davidcutting42/robotarm-17/MK2-WM-Roboarm/Regionals/Remaining Tasks.docx

2017 Regionals Roboarm MK2 Changes

## High Priority

### Hardware

### Software

### Operational

- Update waypoints with lifting between each waypoint (make sure end effector will not spill pennies)
- Mitigate risk of motors getting stuck/loss of penny stack
- 10 practice runs

## Low Priority

### Hardware

- Print penny harp with wider angle to make pennies more secure

### Software

- Calculate step differences every time encoders are read.
- Remove decrement code for the step differences because the encoders already manage that.
- In state machines, update code in going into state one and leaving state two so there is a dead band.
- Update modbus registers with three new variables for angle positions (degrees*100)

### Operational
