davidcutting42/robotarm-17/Robot Arm 2017 Arduino Mega Shield V2 Schematic.pdf

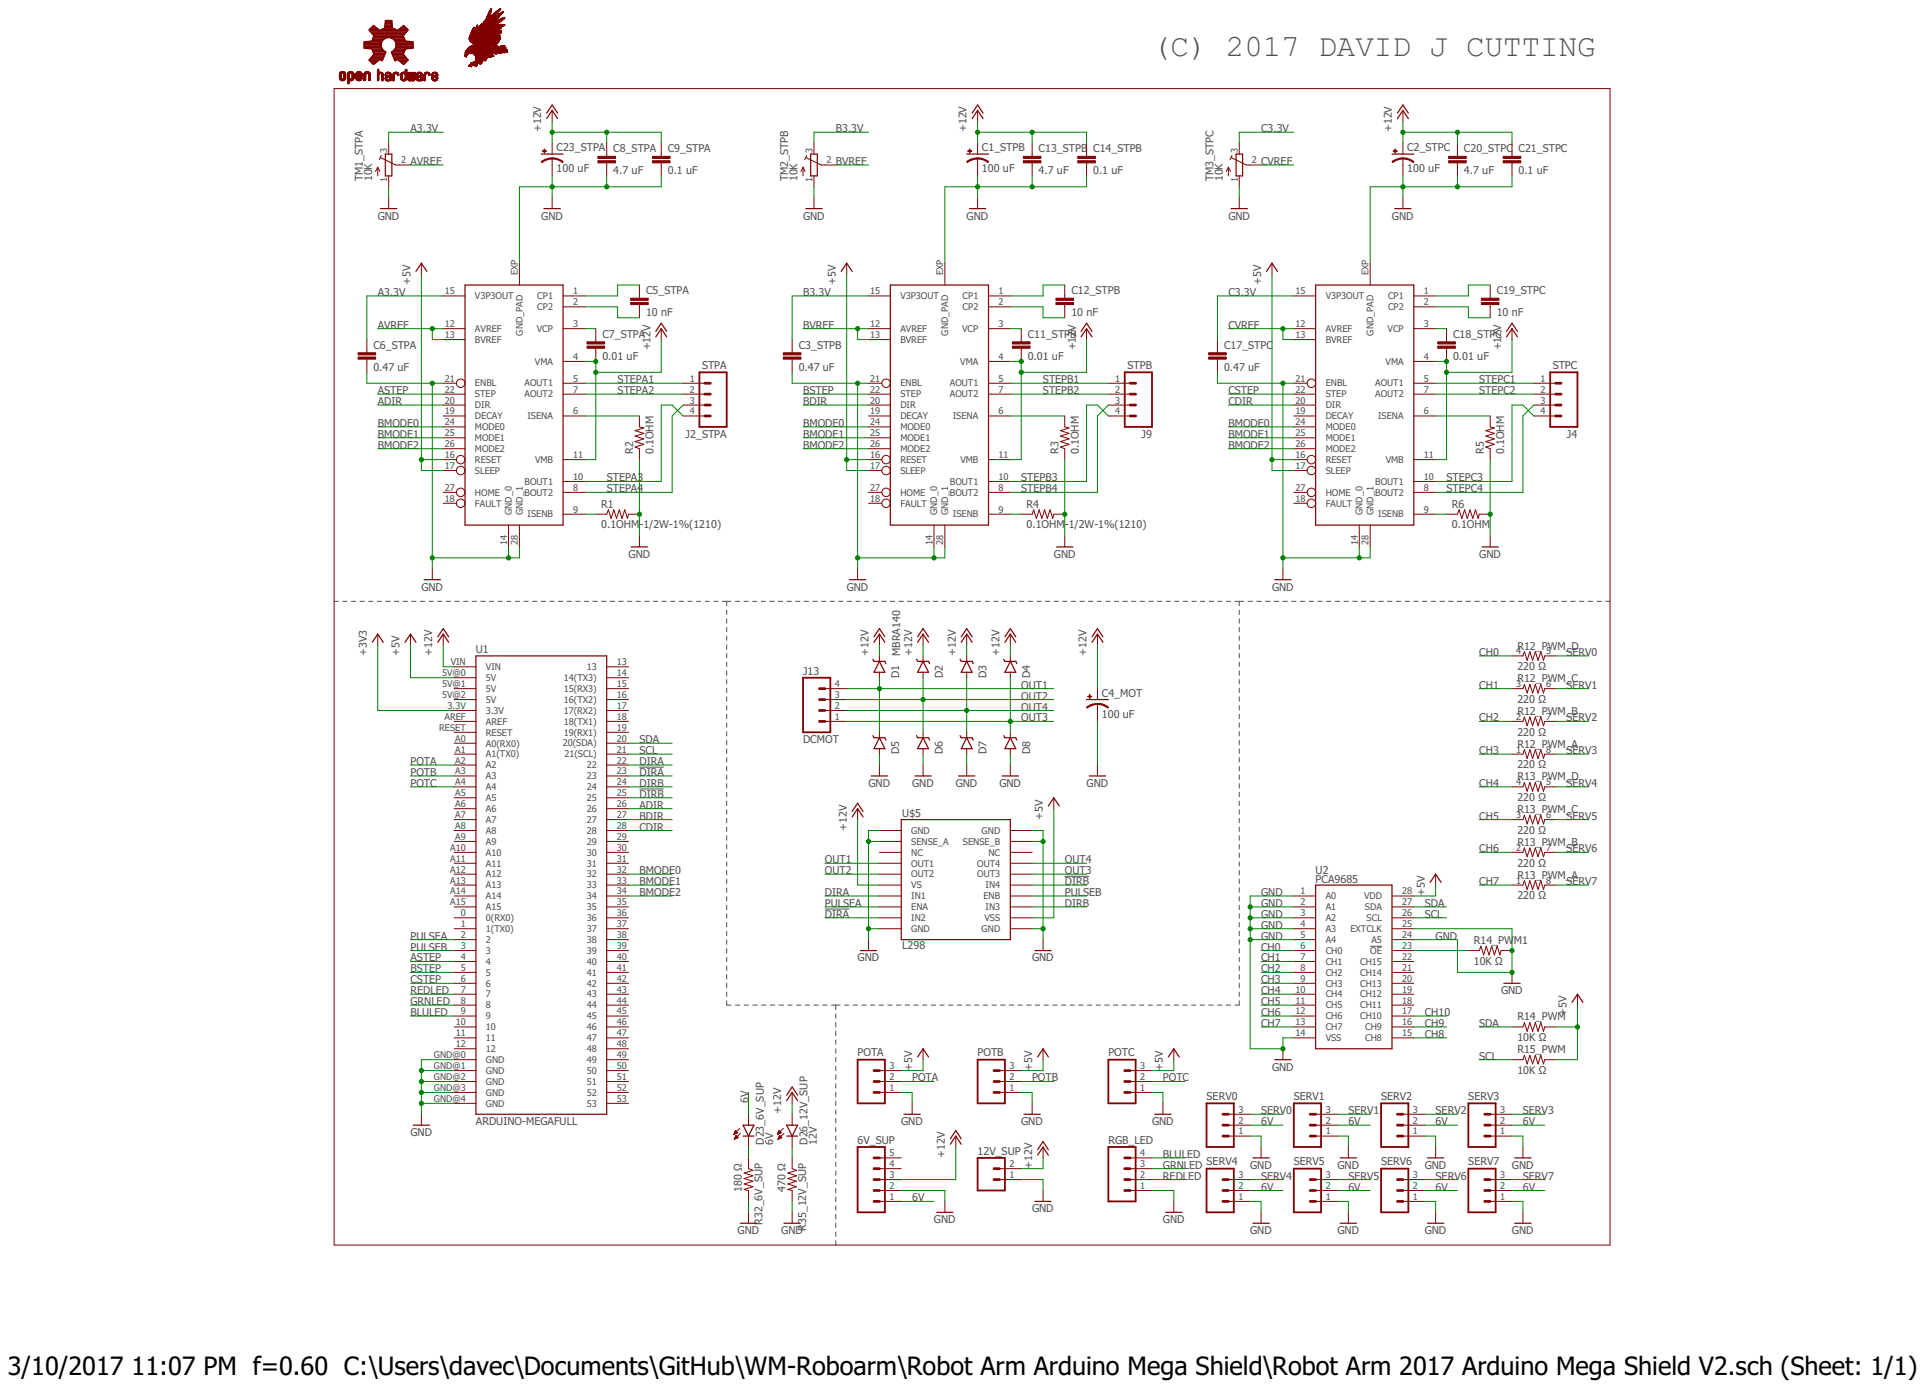
[picture p1: page 1]

MBRA140 GND GND GND GND

3/10/2017 11:07 PM f=0.60 C:\Users\davec\Documents\GitHub\WM-Roboarm\Robot Arm Arduino Mega Shield\Robot Arm 2017 Arduino Mega Shield V2.sch (Sheet: 1/1)
