davidcutting42/robotarm-17/Robot Arm 2017 Arduino Mega Shield V2.pdf

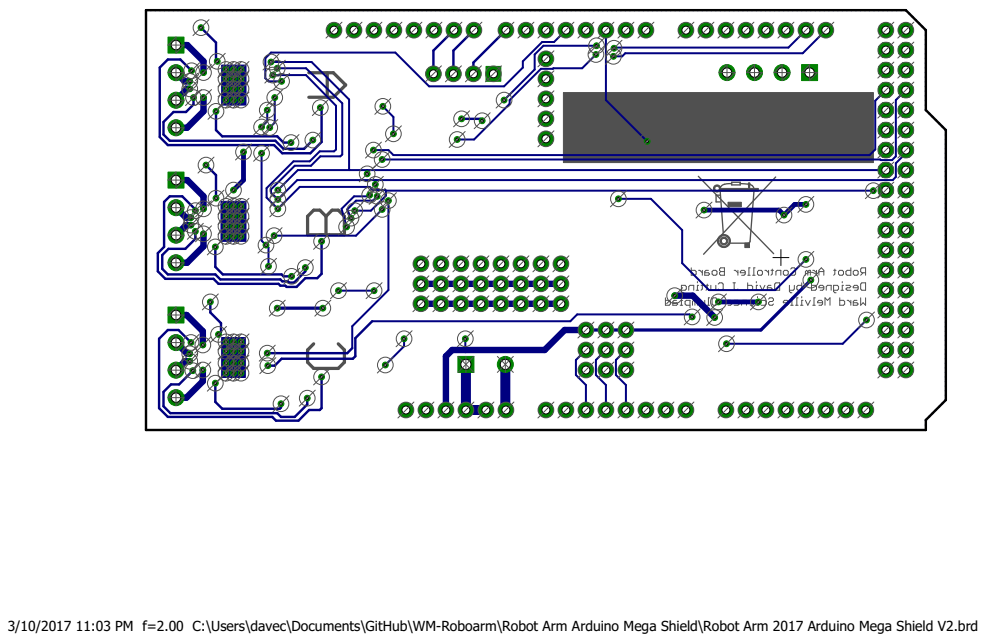
[picture p2: page 1]

3/10/2017 11:03 PM f=2.00 C:\Users\davec\Documents\GitHub\WM-Roboarm\Robot Arm Arduino Mega Shield\Robot Arm 2017 Arduino Mega Shield V2.brd
