davidcutting42/robotarm-17/MK1-WM-Roboarm/Documentation/osttexx0164.pdf

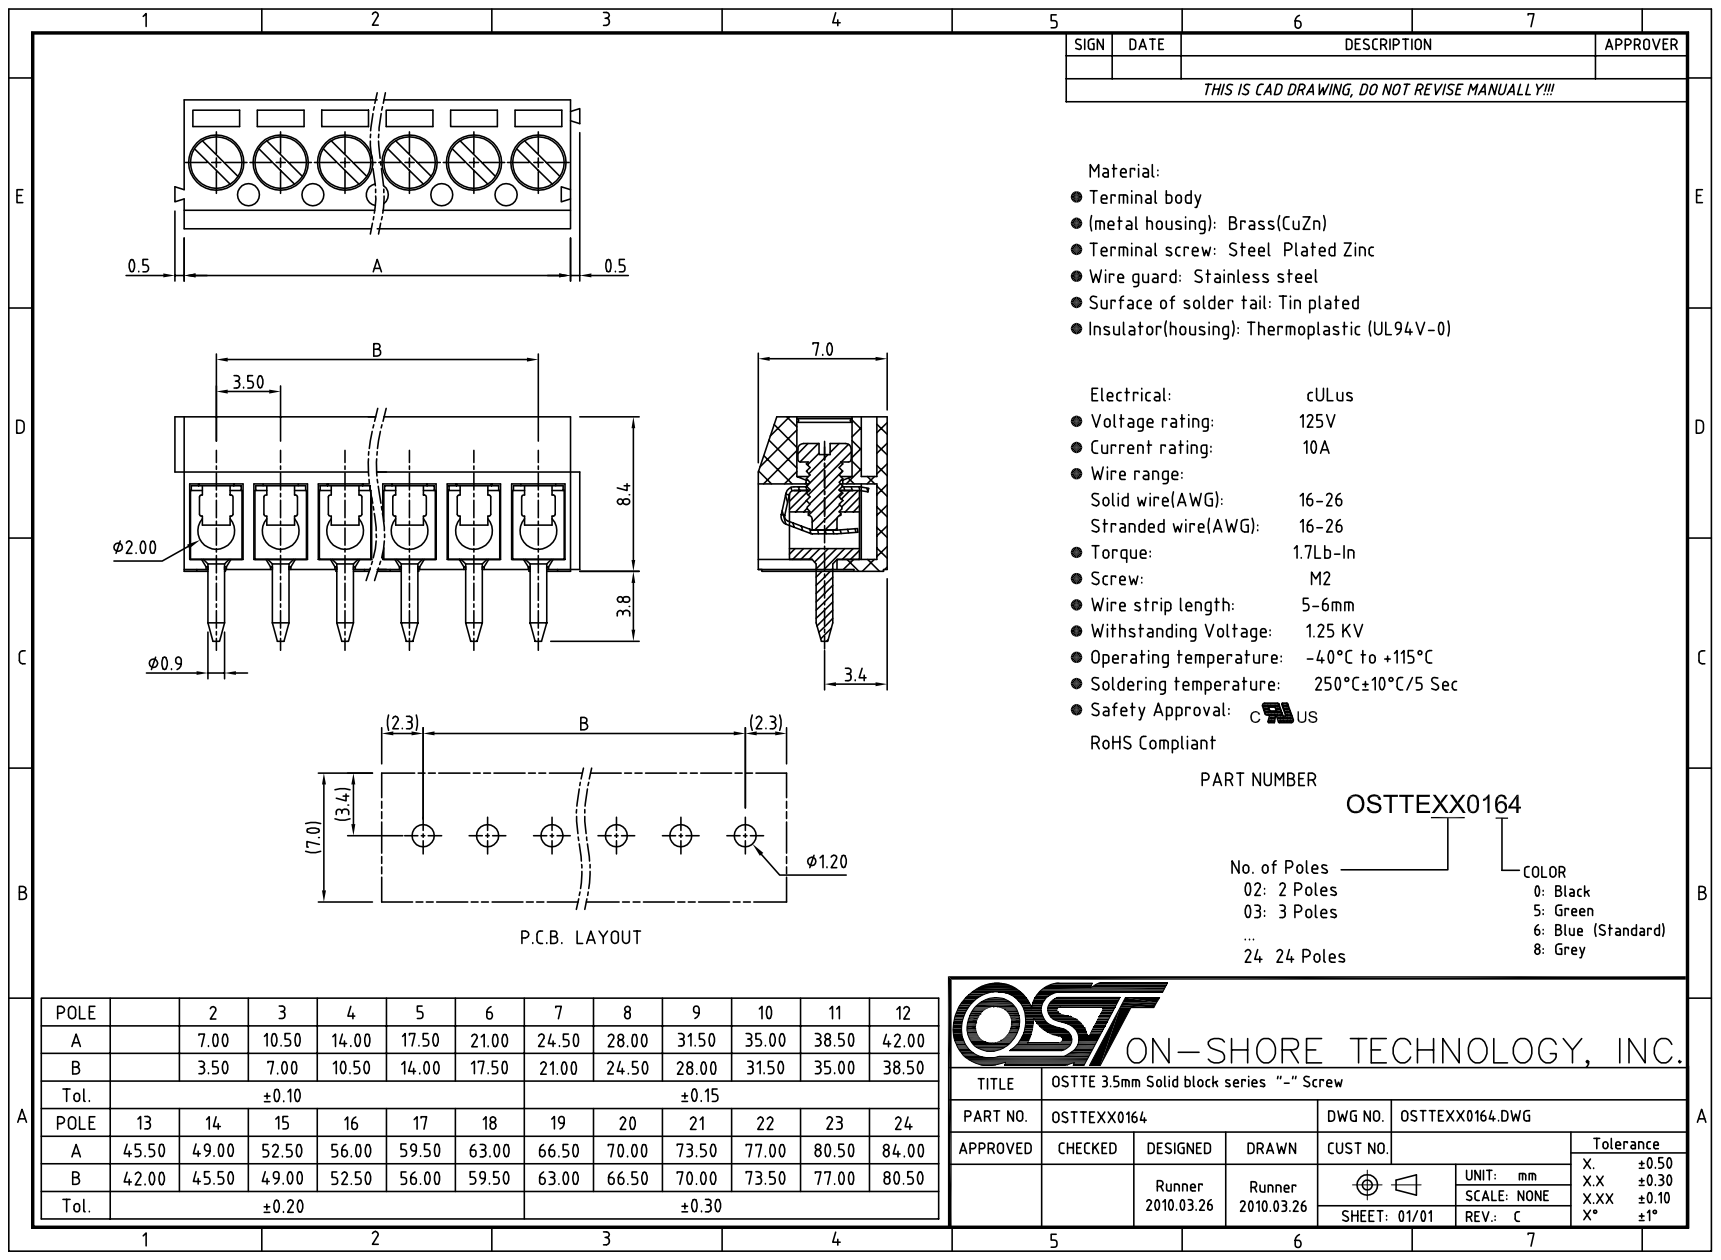
[picture p3: page 1]
