davidcutting42/robotarm-17/(commit log)

2016-10-04 Initial commit for robot arm code files
2016-10-10 Updated Readme and started new inverse kinematics code.
    [WM-Roboarm.urdf]
2016-10-11 Defined Roboarm in URDF file and reorganized files.
    [WM-Roboarm.urdf]
2016-10-12 Updated Code in Current Python Directory
    [WM_Roboarm_Inv_Kin_Def.urdf]
2016-10-20 Made code operational with basic bug fixes. Much more work to do.
    [WM_Roboarm_Inv_Kin_Def.urdf]
2016-12-02 Increased speed of steppers, added limits.
2016-12-02 Added basic UI that sets values of servos over Modbus
2016-12-02 Added LED driver code and began implementation of servo control in Arduino Mega code
2016-12-04 Added servo control logic to arduino code.
2016-12-08 Added more features to drive servos and make code overall more stable.
2016-12-09 Stabilized servo code
2016-12-10 Fixed stepper motor control issues.
    [Arduino_Mega_Code.ino]
2016-12-10 Calibrated servos and updated UI
2016-12-31 Reorganized filesystem for development of MK2 and added arduino code that was previously being developed out of this repository.
    [WM_Roboarm_Inv_Kin_Def.urdf]
2017-01-01 Made arm functional using manual commands
2017-01-03 Bug fixes and stability upgrades. There's something still wrong with the atan2 function that calculates the beta angle, needs more work.
    [Arduino_Code_MK2_WM_Roboarm.ino]
2017-01-05 Bug fixes and other improvements
    [Arduino_Code_MK2_WM_Roboarm.ino]
2017-01-07 More bug fixes and improved stepper motor behavior.
    [Arduino_Code_MK2_WM_Roboarm.ino]
2017-01-07 Removed the (hopefully) last bug preventing correct placement of the arm's end in cartesian space. Time to move on to the end effector and python side of things.
    [Arduino_Code_MK2_WM_Roboarm.ino]
2017-01-14 Added provisions on arduino code for modbus communication, pluis control for a fourth stepper motor and two servos.
    Also simplified main loop for easier reading.
2017-01-14 More changes to motor control, etc. Also added program to calibrate and find positions of pennies using a simple UI
2017-01-15 Added calibration UI improvements and set up new waypoint structures.
2017-01-17 Changed main input method for calibration to buttons.
2017-01-17 Fixed minor bug in python code related to file reading
    [Python-Code-MK2-WM-Roboarm.py]
2017-01-17 Changed calibration speeds and added more beta waypoints.
2017-01-20 Calibrated waypoints further.
2017-01-20 Added auto-sequencing and fixed some waypoints.
    [Arduino_Code_MK2_WM_Roboarm.ino, Python-Code-MK2-WM-Roboarm.py]
2017-01-20 Made changes to different modes and how they are switched between
2017-01-21 Code updated to version used at MIT (late night hotel lobby changes ;) ). All code is now being moved to new folders so a competition-by-competition archive can be traced later on.
2017-01-25 Added capability for encoder input, still needs more work to allow zeroing, also need to remove old code that will interfere with encoders.
    [Arduino_Code_MK2_WM_Roboarm.ino]
2017-01-28 Created practice log
    [Regionals Practice Log.xlsx]
2017-01-28 Added list of Arduino libraries to README.md
2017-01-28 Added communication of angle registers between master and slave devices.
2017-01-28 Fixed bug in register size
    [Arduino_Code_MK2_WM_Roboarm.ino]
2017-01-28 Fixed bug in transmission of float on modbus
    [Arduino_Code_MK2_WM_Roboarm.ino, Python-Code-MK2-WM-Roboarm.py]
2017-01-28 Reorganized files to reflect scrapping of encoder code for regionals because of time constraints, plus removal of double register writing bug in python code. Moved all encoder implementation code to 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
    [Regionals Practice Log.xlsx]
2017-01-30 Final regionals debugs
    [Regionals Practice Log.xlsx]
2017-02-01 Restructured filesystem and began making modifications for implementation of new modbus library
    [Regionals Practice Log.xlsx, SOUP Practice Log.xlsx]
2017-02-04 Added I2C scanner code
2017-02-07 Full alpha implementation of encoders
2017-02-07 Made further changes to alpha version or encoder supporting code
2017-02-08 Bug fixes, steppers react to encoder positions but have incorrect directions/speeds and are very choppy because motor control is taking too long.
    [SOUP-Python-Code-MK2-WM-Roboarm.py, SOUP_Arduino_Code_MK2_WM_Roboarm.ino, SOUP_Arduino_Zeroing_Code_MK2_WM_Roboarm.ino]
2017-02-10 Fixed more probems with stepper motors
    [SOUP_Arduino_Code_MK2_WM_Roboarm.ino]
2017-02-11 Bug fixes and full implementation of interrupt-run code with ISR
    [SOUP_Arduino_Code_MK2_WM_Roboarm.ino]
2017-02-13 More bug fixes, increasing execution speed, etc.
    [SOUP_Arduino_Code_MK2_WM_Roboarm.ino]
2017-02-15 Full implementation of servo C code, optimization of python code (SOUP)
2017-02-15 Added servo C to waypoints
2017-02-16 Fixes to ISRs, stable but need some UI upgrades and calibration.
    [SOUP-Python-Code-MK2-WM-Roboarm.py, SOUP_Arduino_Code_MK2_WM_Roboarm.ino]
2017-02-16 Calibration work added
2017-02-16 Still not operational, needs some further bug fixes, especially the issue of zeroing the encoders.
    [SOUP_Arduino_Code_MK2_WM_Roboarm.ino, SOUP_Arduino_Zeroing_Code_MK2_WM_Roboarm.ino]
2017-02-16 Modified zeroing reference, allows positioning of motor in more convenient positiono to zero it.
2017-02-16 Bug fixes, still has encoder zeroing issues
    [SOUP_Arduino_Code_MK2_WM_Roboarm.ino]
2017-02-16 Changes in conversion of encoder results
2017-02-16 All motors functional and operating, still needs final calibration and adjustment.
2017-02-18 Hybridized MIT and SOUP control code because 3rd encoder is broken
    [SOUP_Arduino_Code_MK2_WM_Roboarm.ino]
2017-02-18 Reverted back to old code because of hardware failure
    [MITSOUP_Arduino_Code_MK2_WM_Roboarm.ino, SOUP_Arduino_Code_MK2_WM_Roboarm.ino]
